Nandorroloco/Seguimiento/fotos/Materiales Utilizados_1.jpeg

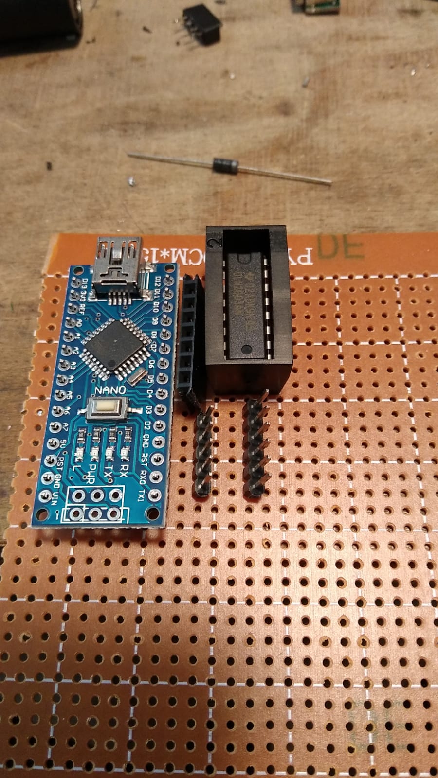
fotos/Materiales Utilizados_1.jpeg
