Nandorroloco/Seguimiento/fotos/Circuito Montado_1.jpeg

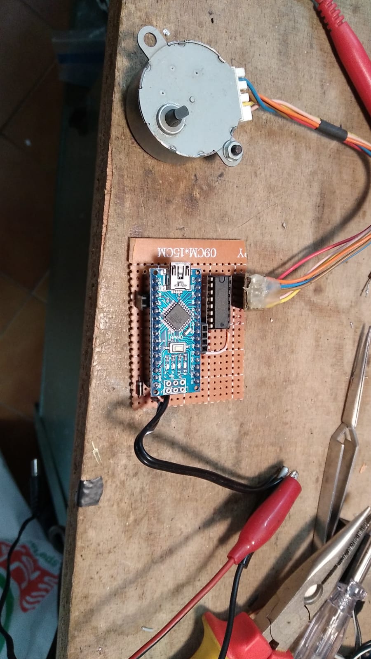
fotos/Circuito Montado_1.jpeg
