Nandorroloco/Seguimiento/Electronica/Calculos Seguimiento AR.xlsx

Calculos para seguimiento en Ascensión Recta con un motor paso a paso y reductora
A rellenar los campos en amarillo
A configurar en Arduino los campos en azul
 | Modo motor |  |  | Paso completo |  | 1/2 paso
 | nº pasos motor |  |  | 48 |  | 96 | Frecuencia del cristal | 16000000.00
 | reductora |  |  | 42.5 |  | 42.5
 | dientes corona AR |  |  | 120 |  | 120 | Definición SLOW en ticks (=V_Sideral) | 40
 | Pasos totales |  |  | 244800 |  | 489600 | Corresponde a la velocidad sideral
 | Resolución por paso (arcsec) |  |  | 5.294117647 |  | 2.647058824
 |  |  |  |  |  |  | inverso de pasos por segundo sideral (1/E14) | 0.3519775327
 | Pasos por segundo (Sideral) |  |  | 2.841090431 |  | 5.682180862 | igual a los microsegundos (L14*1.000.000) | 351977.5327
 | Pasos por segundo (Solar) |  |  | 2.833333333 |  | 5.666666667 | Entonces un tick... La curantaava parte (L15/L10) | 8799.438317
 | Pasos por segundo (Lunar) |  |  | 2.737393857 |  | 5.474787714
 |  |  |  |  |  |  | Es el valor a programar en el trimmer | 8800
 | Velocidad seguimiento Sideral |  |  |  | 15.04106699 | arcseg/segundo
 | Velocidad seguimiento Solar |  |  |  | 15 | arcseg/segundo
 | Velocidad seguimiento Lunar |  |  |  | 14.49208512 | arcseg/segundo
 | Segundos de arco de 1 vuelta completa de la montura en Ascensión Recta
 | 1 vuelta = | 360 | grados
 | 1 vuelta = |  |  |  | 1296000 | arcseg
 | Segundos de un día sidereo
 | 1 dia sidereo = 23 horas 56 minutos y 4,1 segundos aproximadamente
 |  | 23 | 56 | 4.1
 | 1 día sidereo = | 82800 | 3360 | 4.1 | 86164.1 | Segundos
 | Segundos de un día Solar
 | 1 dia solar = | 24 | horas
 | 1 día sidereo = |  |  |  | 86400 | Segundos
 | Segundos de un dia lunar
 | 1 dia lunar varia de un dia a otro, los datos aquí puestos son de ejemplo
 |  | 24 | 50 | 28.125
 |  | 86400 | 3000 | 28.125 | 89428.125 | Segundos
