Nandorroloco/Seguimiento/Electronica/Seguimiento_v2.BMP

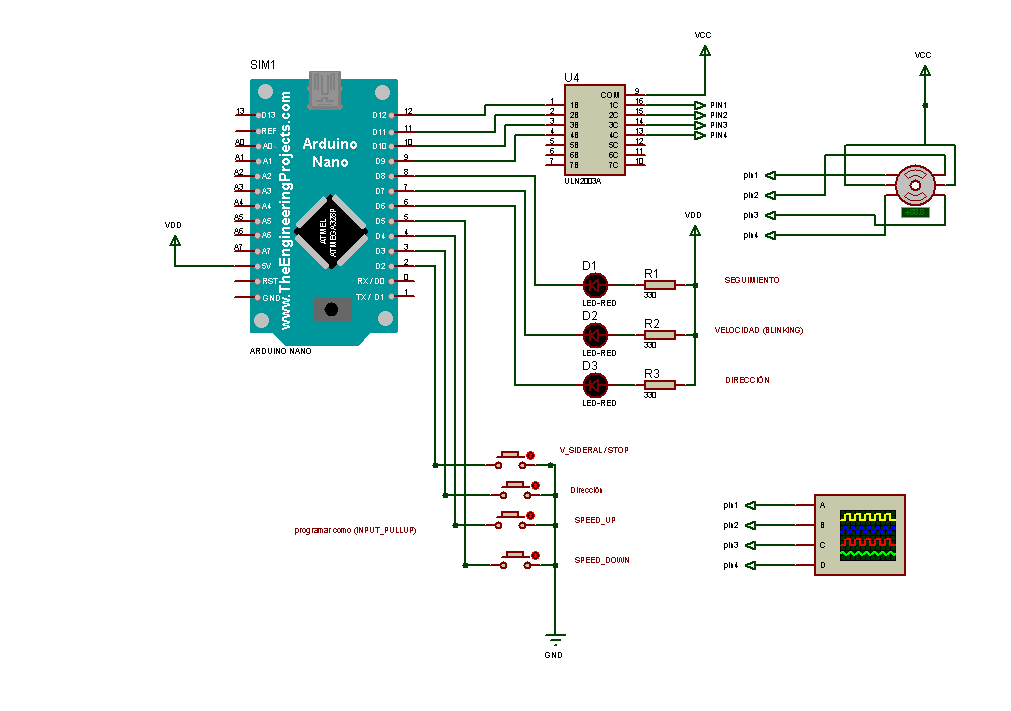
Electronica/Seguimiento_v2.BMP
