Nandorroloco/Seguimiento/fotos/Circuito Montado 2.jpeg

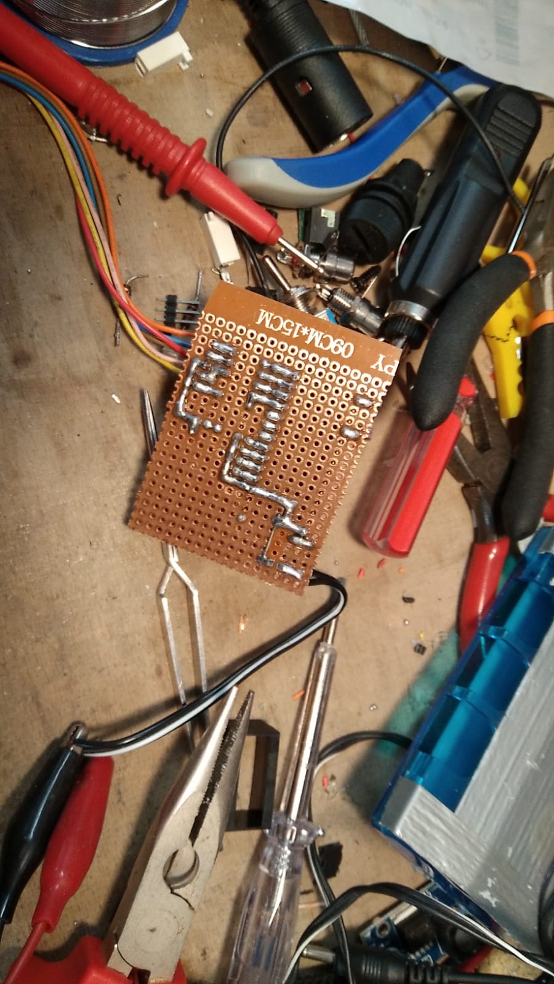
fotos/Circuito Montado 2.jpeg
