Nandorroloco/Seguimiento/fotos/Inventito_1.jpeg

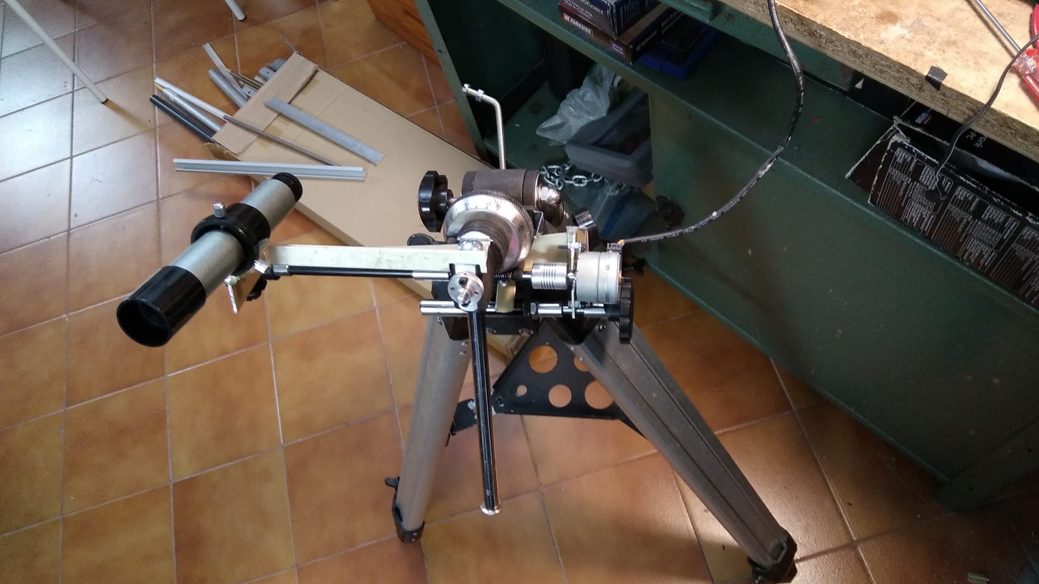
fotos/Inventito_1.jpeg
