Nandorroloco/Seguimiento/(commit log)

2022-01-26 Versión inicial
    Primera release.
    [Calculos Seguimiento AR.xlsx]
2022-02-13 Create Seguimiento_v2.1.ino
    Se define un valor empírico para que el timmer ajuste el tiempo de manera que 2040 pasos en velocidad SLOW sean exactamente 12 minutos (5 vueltas a la hora).
    El valor teórico calculado con la hoja de cálculo son 8800 microsegundos, pero... el valor empírico son un 2% menos, unos 8600 microsegundos, de esta manera una montura con 120 dientes en la corona del eje AR funcionará bien.
